JMattChiam/ChordStrummer/hardware/strummer case.3mf

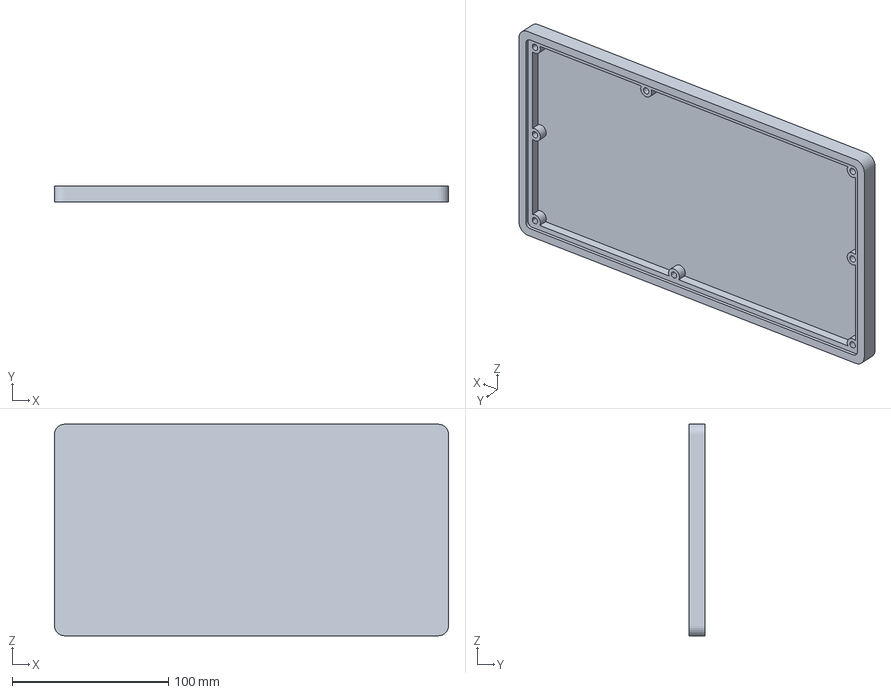
[picture p1: CAD file, 2023-09-24]
hardware/strummer case.3mf
252.3 x 10.0 x 135.5 mm
