JMattChiam/ChordStrummer/hardware/circuit.brd

## EAGLE design hardware/circuit.brd (2023-06-12)

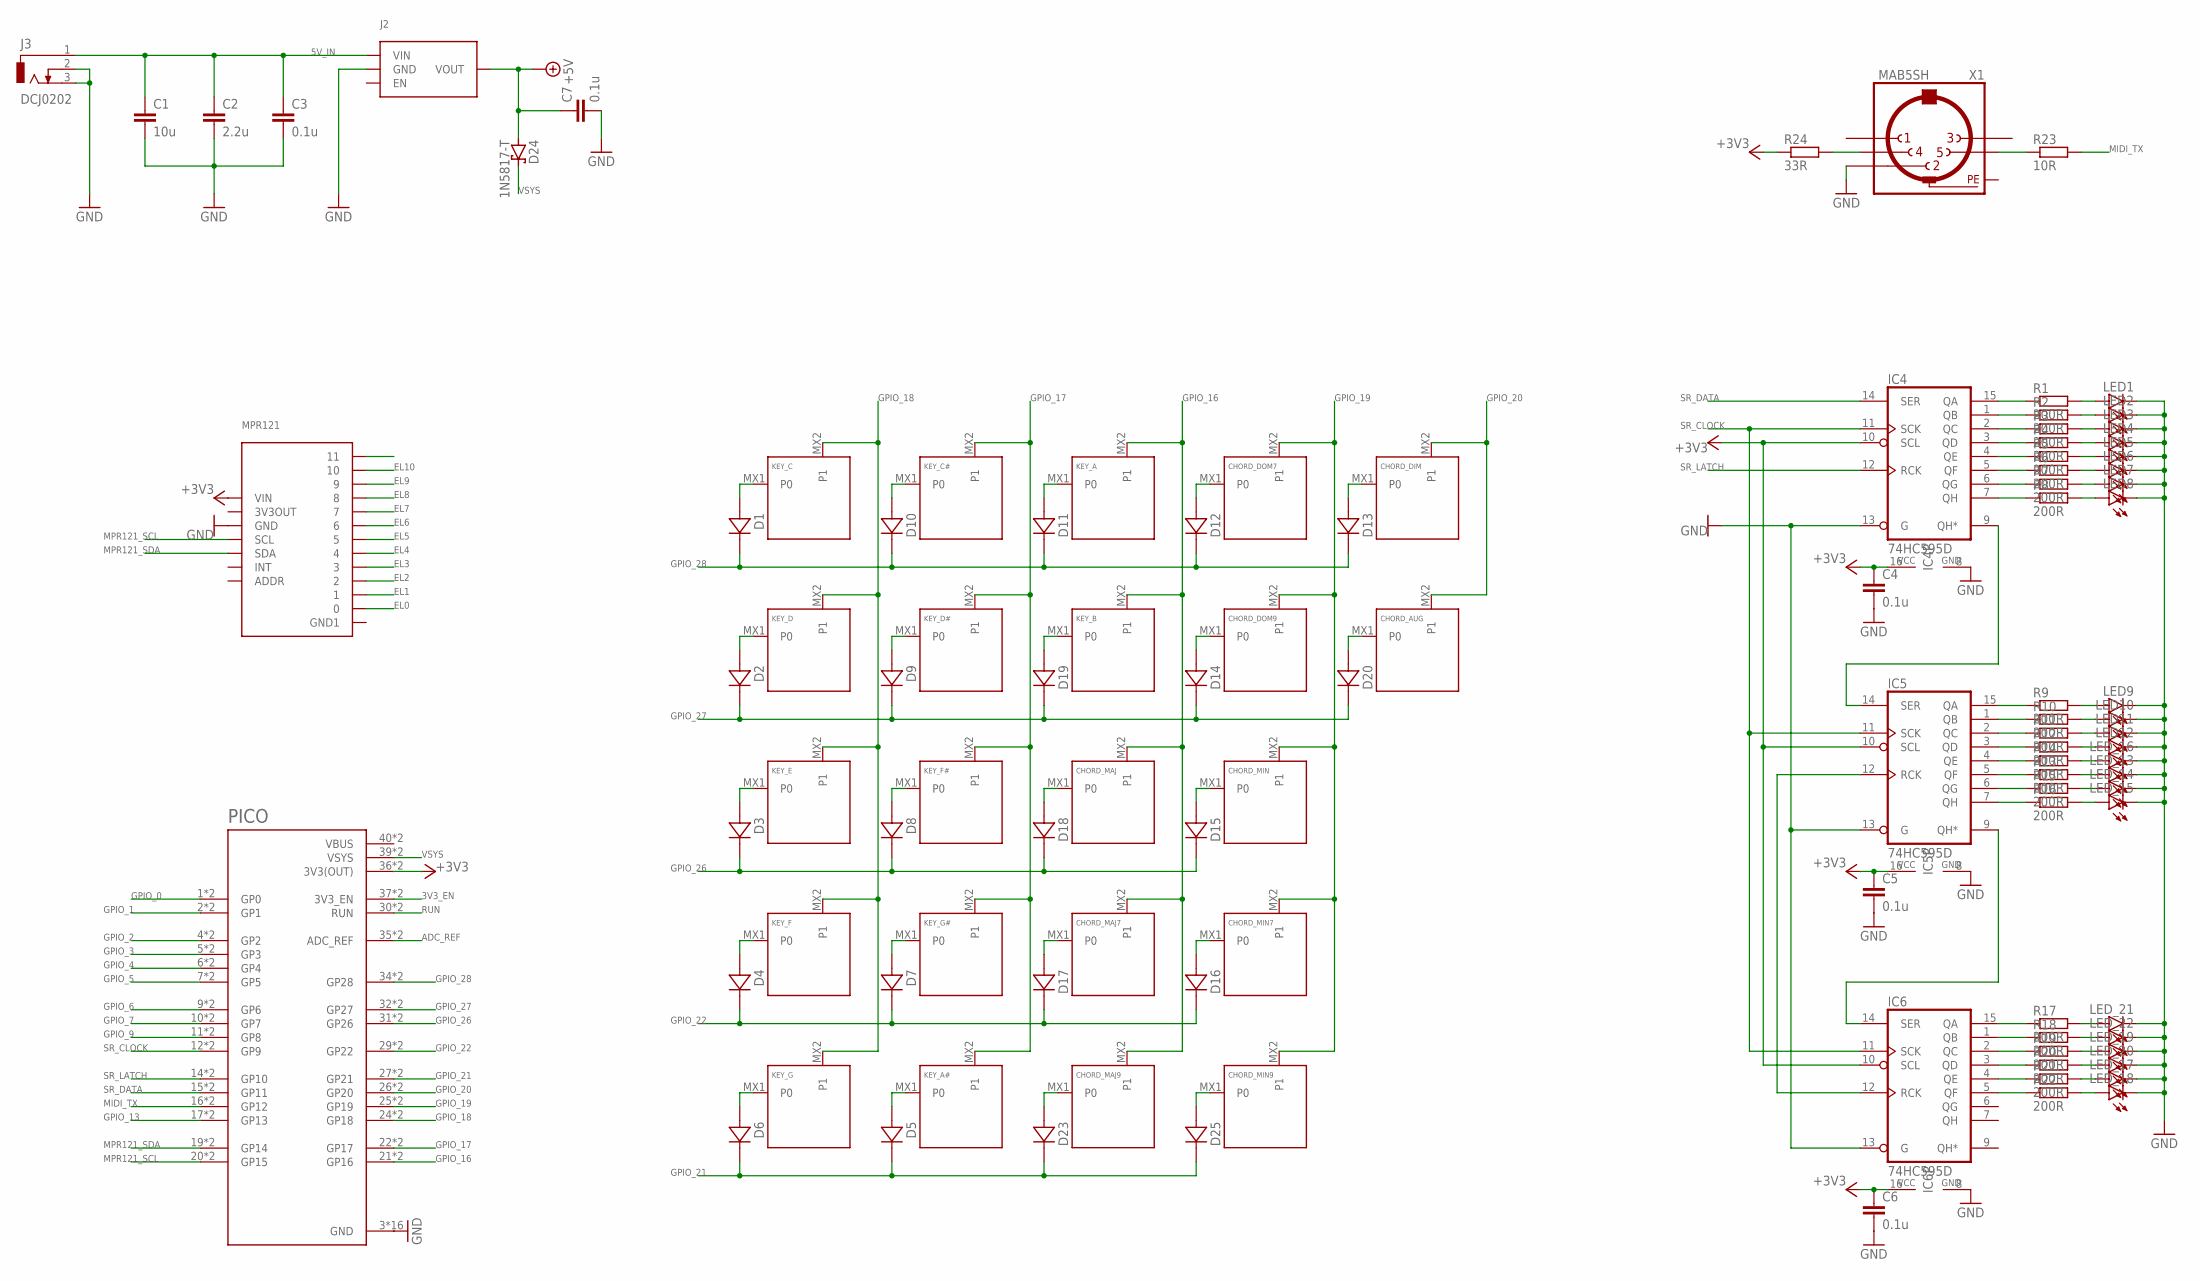
[picture p2: schematic circuit.sch]

Parts:
C1: 10u; C5B2.5
C2: 2.2u; C5B2.5
C3, C4, C5, C6, C7: 0.1u; C0805
CHORD_AUG: KEYSWITCH-PLAIN-MX-1U; MX-1U
CHORD_DIM: KEYSWITCH-PLAIN-MX-1U; MX-1U
CHORD_DOM7, CHORD_DOM9: KEYSWITCH-PLAIN-MX-1U; MX-1U
CHORD_MAJ, CHORD_MAJ7, CHORD_MAJ9: KEYSWITCH-PLAIN-MX-1U; MX-1U
CHORD_MIN, CHORD_MIN7, CHORD_MIN9: KEYSWITCH-PLAIN-MX-1U; MX-1U
D1, D2, D3, D4, D5, D6, D7, D8, D9, D10, D11, D12, D13, D14, D15, D16, D17, D18, D19, D20, D23, D25: DIODE-SOD-323; SOD-323
D24: 1N5817-T; DO41-7.6
IC4, IC5, IC6: 74HC595D; SO16
J2: DCDC_MINI_CONVERTER
J3: DCJ0202
KEY_A: KEYSWITCH-PLAIN-MX-1U; MX-1U
KEY_A#: KEYSWITCH-PLAIN-MX-1U; MX-1U
KEY_B: KEYSWITCH-PLAIN-MX-1U; MX-1U
KEY_C: KEYSWITCH-PLAIN-MX-1U; MX-1U
KEY_C#: KEYSWITCH-PLAIN-MX-1U; MX-1U
KEY_D: KEYSWITCH-PLAIN-MX-1U; MX-1U
KEY_D#: KEYSWITCH-PLAIN-MX-1U; MX-1U
KEY_E: KEYSWITCH-PLAIN-MX-1U; MX-1U
KEY_F: KEYSWITCH-PLAIN-MX-1U; MX-1U
KEY_F#: KEYSWITCH-PLAIN-MX-1U; MX-1U
KEY_G: KEYSWITCH-PLAIN-MX-1U; MX-1U
KEY_G#: KEYSWITCH-PLAIN-MX-1U; MX-1U
LED1, LED2, LED3, LED4, LED5, LED6, LED7, LED8, LED9, LED10, LED11, LED12: LEDCHIPLED_0805; CHIPLED_0805
LED_13, LED_14, LED_15, LED_16, LED_17, LED_18, LED_19, LED_20, LED_21, LED_22: LEDCHIPLED_0805; CHIPLED_0805
MPR121: MPR121_ADAFRUIT; ADAFRUIT_MPR121
PICO: RASPBERRY_PICO-NO_DEBUG; PICO-PKG-NO_DEBUG
R1, R2, R3, R4, R5, R6, R7, R8, R9, R10, R11, R12, R13, R14, R15, R16, R17, R18, R19, R20, R21, R22: 200R; R0805
R23: 10R; R0805
R24: 33R; R0805
X1: MAB5SH

Connections:
3V3_EN: PICO.37 (3V3_EN), PICO.P$37 (3V3_EN)
5V_IN: C1.1, C2.1, C3.1, J2.VIN, J3.1
+3V3: C4.1, C5.1, C6.1, IC4.10 (SCL), IC4.16 (VCC), IC5.10 (SCL), IC5.16 (VCC), IC6.10 (SCL), IC6.16 (VCC), MPR121.VCC (VIN), PICO.36 (3V3(OUT)), PICO.P$36 (3V3(OUT)), R24.1
+5V: C7.1, D24.A, J2.VOUT
ADC_REF: PICO.35 (ADC_REF), PICO.P$35 (ADC_REF)
EL0: MPR121.0
EL1: MPR121.1
EL2: MPR121.2
EL3: MPR121.3
EL4: MPR121.4
EL5: MPR121.5
EL6: MPR121.6
EL7: MPR121.7
EL8: MPR121.8
EL9: MPR121.9
EL10: MPR121.10
EL11: MPR121.11
GND: C1.2, C2.2, C3.2, C4.2, C5.2, C6.2, C7.2, IC4.8 (GND), IC4.13 (G), IC5.8 (GND), IC5.13 (G), IC6.8 (GND), IC6.13 (G), J2.GND, J3.2, J3.3, LED1.C, LED2.C, LED3.C, LED4.C, LED5.C, LED6.C, LED7.C, LED8.C, LED9.C, LED10.C, LED11.C, LED12.C, LED_13.C, LED_14.C, LED_15.C, LED_16.C, LED_17.C, LED_18.C, LED_19.C, LED_20.C, LED_21.C, LED_22.C, MPR121.GND, PICO.3 (GND), PICO.8 (GND), PICO.13 (GND), PICO.18 (GND), PICO.23 (GND), PICO.28 (GND), PICO.33 (GND), PICO.38 (GND), PICO.P$3 (GND), PICO.P$8 (GND), PICO.P$13 (GND), PICO.P$18 (GND), PICO.P$23 (GND), PICO.P$28 (GND), PICO.P$33 (GND), PICO.P$38 (GND), X1.2
GPIO_0: PICO.1 (GP0), PICO.P$1 (GP0)
GPIO_1: PICO.2 (GP1), PICO.P$2 (GP1)
GPIO_2: PICO.4 (GP2), PICO.P$4 (GP2)
GPIO_3: PICO.5 (GP3), PICO.P$5 (GP3)
GPIO_4: PICO.6 (GP4), PICO.P$6 (GP4)
GPIO_5: PICO.7 (GP5), PICO.P$7 (GP5)
GPIO_6: PICO.9 (GP6), PICO.P$9 (GP6)
GPIO_7: PICO.10 (GP7), PICO.P$10 (GP7)
GPIO_9: PICO.11 (GP8), PICO.P$11 (GP8)
GPIO_13: PICO.17 (GP13), PICO.P$17 (GP13)
GPIO_16: CHORD_MAJ.MX2 (P1), CHORD_MAJ7.MX2 (P1), CHORD_MAJ9.MX2 (P1), KEY_A.MX2 (P1), KEY_B.MX2 (P1), PICO.21 (GP16), PICO.P$21 (GP16)
GPIO_17: KEY_A#.MX2 (P1), KEY_C#.MX2 (P1), KEY_D#.MX2 (P1), KEY_F#.MX2 (P1), KEY_G#.MX2 (P1), PICO.22 (GP17), PICO.P$22 (GP17)
GPIO_18: KEY_C.MX2 (P1), KEY_D.MX2 (P1), KEY_E.MX2 (P1), KEY_F.MX2 (P1), KEY_G.MX2 (P1), PICO.24 (GP18), PICO.P$24 (GP18)
GPIO_19: CHORD_DOM7.MX2 (P1), CHORD_DOM9.MX2 (P1), CHORD_MIN.MX2 (P1), CHORD_MIN7.MX2 (P1), CHORD_MIN9.MX2 (P1), PICO.25 (GP19), PICO.P$25 (GP19)
GPIO_20: CHORD_AUG.MX2 (P1), CHORD_DIM.MX2 (P1), PICO.26 (GP20), PICO.P$26 (GP20)
GPIO_21: D5.C, D6.C, D23.C, D25.C, PICO.27 (GP21), PICO.P$27 (GP21)
GPIO_22: D4.C, D7.C, D16.C, D17.C, PICO.29 (GP22), PICO.P$29 (GP22)
GPIO_26: D3.C, D8.C, D15.C, D18.C, PICO.31 (GP26), PICO.P$31 (GP26)
GPIO_27: D2.C, D9.C, D14.C, D19.C, D20.C, PICO.32 (GP27), PICO.P$32 (GP27)
GPIO_28: D1.C, D10.C, D11.C, D12.C, D13.C, PICO.34 (GP28), PICO.P$34 (GP28)
MIDI_TX: PICO.16 (GP12), PICO.P$16 (GP12), R23.2
MPR121_SCL: MPR121.SCL, PICO.20 (GP15), PICO.P$20 (GP15)
MPR121_SDA: MPR121.SDA, PICO.19 (GP14), PICO.P$19 (GP14)
unnamed: IC4.9 (QH*), IC5.14 (SER)
unnamed: IC5.9 (QH*), IC6.14 (SER)
unnamed: LED1.A, R1.2
unnamed: LED2.A, R2.2
unnamed: LED3.A, R3.2
unnamed: LED4.A, R4.2
unnamed: LED5.A, R5.2
unnamed: LED6.A, R6.2
unnamed: LED7.A, R7.2
unnamed: LED8.A, R8.2
unnamed: LED9.A, R9.2
unnamed: LED10.A, R10.2
unnamed: LED11.A, R11.2
unnamed: LED12.A, R12.2
unnamed: LED_16.A, R14.2
unnamed: LED_13.A, R13.2
unnamed: LED_15.A, R16.2
unnamed: LED_14.A, R15.2
unnamed: LED_21.A, R17.2
unnamed: LED_22.A, R18.2
unnamed: LED_19.A, R19.2
unnamed: LED_20.A, R20.2
unnamed: LED_17.A, R21.2
unnamed: LED_18.A, R22.2
unnamed: IC4.15 (QA), R1.1
unnamed: IC4.1 (QB), R2.1
unnamed: IC4.2 (QC), R3.1
unnamed: IC4.3 (QD), R4.1
unnamed: IC4.4 (QE), R5.1
unnamed: IC4.5 (QF), R6.1
unnamed: IC4.6 (QG), R7.1
unnamed: IC4.7 (QH), R8.1
unnamed: IC5.15 (QA), R9.1
unnamed: IC5.1 (QB), R10.1
unnamed: IC5.2 (QC), R11.1
unnamed: IC5.3 (QD), R12.1
unnamed: IC5.5 (QF), R13.1
unnamed: IC5.4 (QE), R14.1
unnamed: IC5.6 (QG), R15.1
unnamed: IC5.7 (QH), R16.1
unnamed: IC6.15 (QA), R17.1
unnamed: IC6.1 (QB), R18.1
unnamed: IC6.2 (QC), R19.1
unnamed: IC6.3 (QD), R20.1
unnamed: IC6.4 (QE), R21.1
unnamed: IC6.5 (QF), R22.1
unnamed: R23.1, X1.5
unnamed: R24.2, X1.4
unnamed: CHORD_MAJ9.MX1 (P0), D23.A
unnamed: CHORD_MIN9.MX1 (P0), D25.A
unnamed: D1.A, KEY_C.MX1 (P0)
unnamed: D10.A, KEY_C#.MX1 (P0)
unnamed: D11.A, KEY_A.MX1 (P0)
unnamed: CHORD_DOM7.MX1 (P0), D12.A
unnamed: CHORD_DIM.MX1 (P0), D13.A
unnamed: D2.A, KEY_D.MX1 (P0)
unnamed: D3.A, KEY_E.MX1 (P0)
unnamed: D4.A, KEY_F.MX1 (P0)
unnamed: D6.A, KEY_G.MX1 (P0)
unnamed: D5.A, KEY_A#.MX1 (P0)
unnamed: D7.A, KEY_G#.MX1 (P0)
unnamed: D8.A, KEY_F#.MX1 (P0)
unnamed: D9.A, KEY_D#.MX1 (P0)
unnamed: D19.A, KEY_B.MX1 (P0)
unnamed: CHORD_MAJ.MX1 (P0), D18.A
unnamed: CHORD_MAJ7.MX1 (P0), D17.A
unnamed: CHORD_MIN7.MX1 (P0), D16.A
unnamed: CHORD_MIN.MX1 (P0), D15.A
unnamed: CHORD_DOM9.MX1 (P0), D14.A
unnamed: CHORD_AUG.MX1 (P0), D20.A
PE: X1.PE, X1.PE@ (PE)
RUN: PICO.30 (RUN), PICO.P$30 (RUN)
SR_CLOCK: IC4.11 (SCK), IC5.11 (SCK), IC6.11 (SCK), PICO.12 (GP9), PICO.P$12 (GP9)
SR_DATA: IC4.14 (SER), PICO.15 (GP11), PICO.P$15 (GP11)
SR_LATCH: IC4.12 (RCK), IC5.12 (RCK), IC6.12 (RCK), PICO.14 (GP10), PICO.P$14 (GP10)
VBUS: PICO.40 (VBUS), PICO.P$40 (VBUS)
VSYS: D24.C, PICO.39 (VSYS), PICO.P$39 (VSYS)

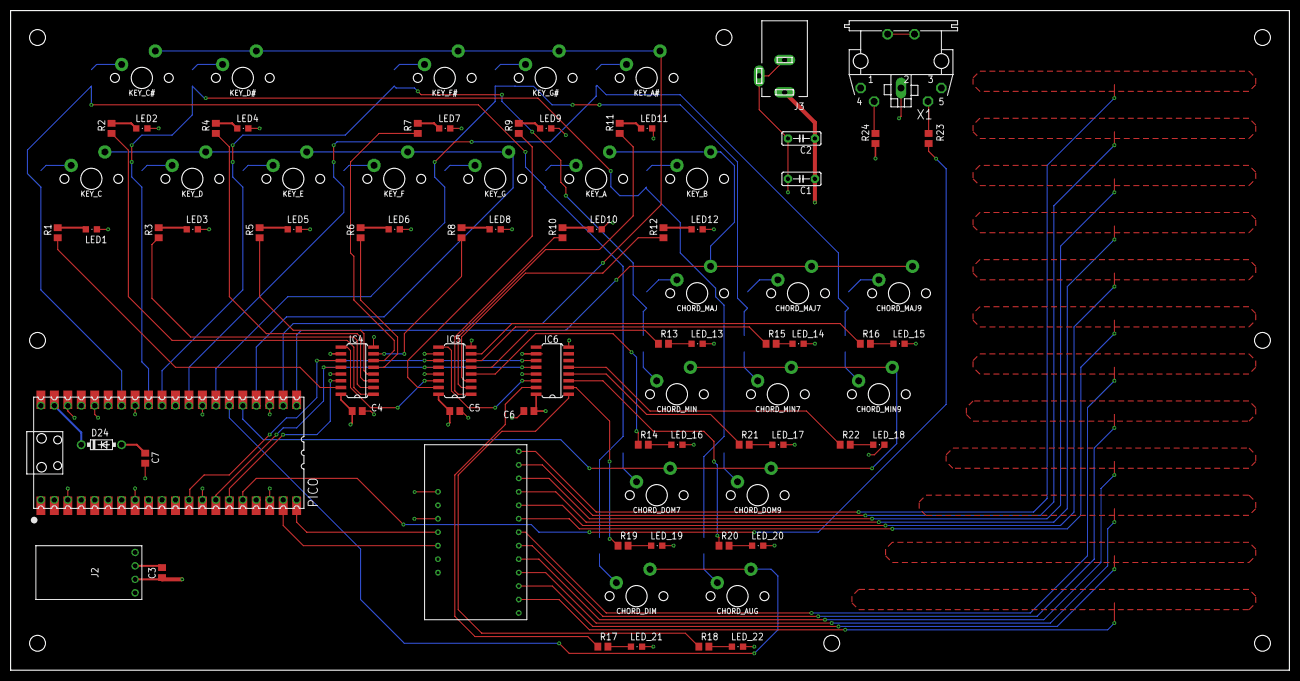
[picture p3: board circuit.brd from above]

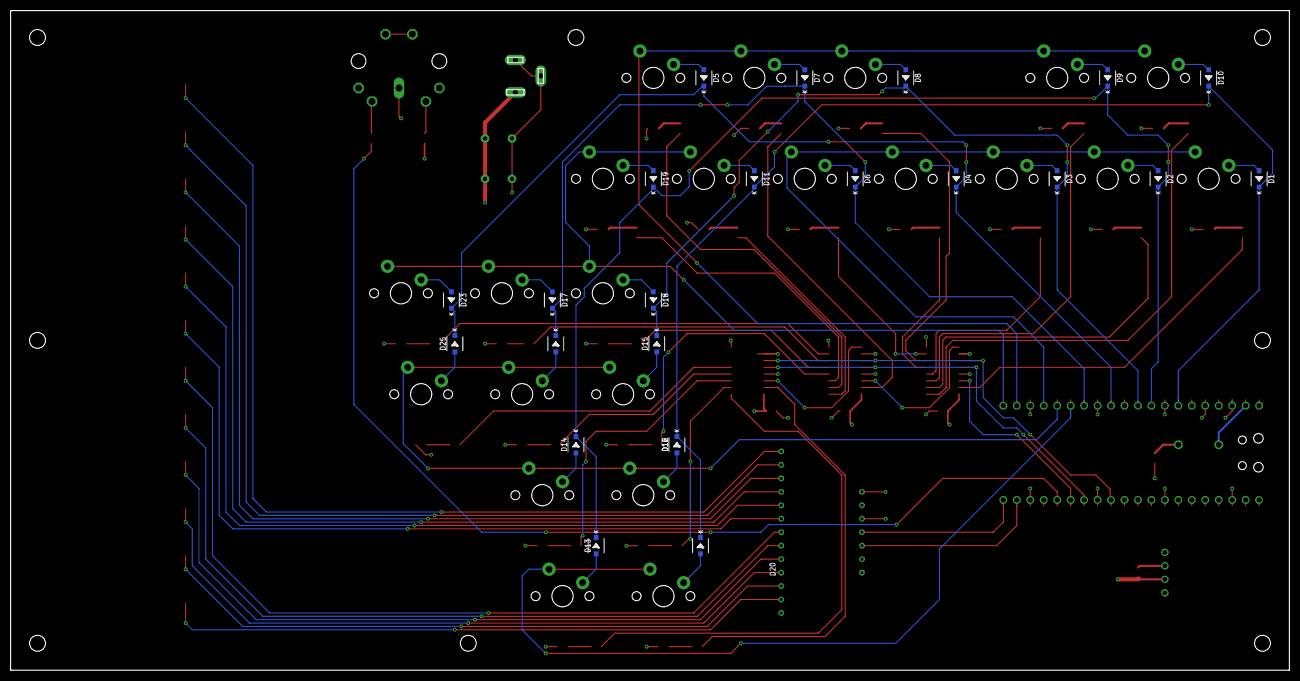
[picture p4: board circuit.brd from below]

Board: 4 copper layers, 241.3 x 124.5 mm, 106 parts (22 on the bottom side), 106 nets.
