JMattChiam/ChordStrummer/(commit log)

2023-06-12 Add EAGLE files
    [circuit.brd, circuit.sch]
2023-06-14 Add LED hex mappings
2023-06-23 Fix bugs
    Board has been soldered. Scanning and LEDs all working now.
    [74HC595.c, 74HC595.h, chord.c, chord.h]
2023-07-03 Add MIDI uart
2023-09-24 Add 3D model for case
    [strummer case.3mf]
